micuentz1/TPO_TD2/README.md

# TPO_TD2
Proyecto Cafetera tipo italiana automática - Técnicas Digitales 2 - Curso R4051 - UTN FRBA - 2022
