micuentz1/TPO_TD2/CafeteraItaliana/Core/Src/main.c

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
/* Includes ------------------------------------------------------------------*/
#include "main.h"
#include "cmsis_os.h"
#include "fatfs.h"

/* USER CODE BEGIN Includes */
#include "liquidcrystal_i2c.h"
#include "OneWire.h"
#include "stdio.h"
#include "MdE.h"
#include "funciones.h"
#include "File_Handling_RTOS.h"
//#include "handlers.h"
/* USER CODE END Includes */

/* USER CODE BEGIN PM */
void my_ftoa(float n, char* res, int afterpoint);
int intToStr(int x, char str[], int d);
void reverse(char* str, int len);
/* USER CODE END PM */

I2C_HandleTypeDef hi2c1;

RTC_HandleTypeDef hrtc;

SPI_HandleTypeDef hspi1;

TIM_HandleTypeDef htim1;
TIM_HandleTypeDef htim3;

UART_HandleTypeDef huart1;

osThreadId defaultTaskHandle;
void SystemClock_Config(void);
static void MX_GPIO_Init(void);
static void MX_I2C1_Init(void);
static void MX_USART1_UART_Init(void);
static void MX_RTC_Init(void);
static void MX_SPI1_Init(void);
static void MX_TIM1_Init(void);
static void MX_TIM3_Init(void);
void StartDefaultTask(void const * argument);

/* USER CODE BEGIN 0 */
extern float Temp[MAXDEVICES_ON_THE_BUS];
TaskHandle_t Handler_Lectura;
TaskHandle_t Handler_Sensores;
TaskHandle_t Handler_Anafe;
TaskHandle_t Handler_Timer;
TaskHandle_t Handler_Timer2;

uint8_t toggle_reset = 1;

extern uint8_t estado_comp;
extern char componentes[4];
/* USER CODE END 0 */

/**
  * @brief  The application entry point.
  * @retval int
  */
int main(void)
{
  /* MCU Configuration--------------------------------------------------------*/

  /* Reset of all peripherals, Initializes the Flash interface and the Systick. */
  HAL_Init();

  /* Configure the system clock */
  SystemClock_Config();

  /* Initialize all configured peripherals */
  MX_GPIO_Init();
  MX_I2C1_Init();
  MX_USART1_UART_Init();
  MX_RTC_Init();
  MX_SPI1_Init();
  MX_FATFS_Init();
  MX_TIM1_Init();
  MX_TIM3_Init();
  /* USER CODE BEGIN 2 */

  InitAll();


  /* USER CODE END 2 */

  /* USER CODE BEGIN RTOS_MUTEX */
  /* add mutexes, ... */
  /* USER CODE END RTOS_MUTEX */

  /* USER CODE BEGIN RTOS_SEMAPHORES */
  /* add semaphores, ... */
  /* USER CODE END RTOS_SEMAPHORES */

  /* USER CODE BEGIN RTOS_TIMERS */
  /* start timers, add new ones, ... */
  /* USER CODE END RTOS_TIMERS */

  /* USER CODE BEGIN RTOS_QUEUES */
  /* add queues, ... */
  /* USER CODE END RTOS_QUEUES */

  /* Create the thread(s) */
  /* definition and creation of defaultTask */
  osThreadDef(defaultTask, StartDefaultTask, osPriorityNormal, 0, 128);
  defaultTaskHandle = osThreadCreate(osThread(defaultTask), NULL);

  /* USER CODE BEGIN RTOS_THREADS */
  /* add threads, ... */


  xTaskCreate(MdE_Principal, "MdE", configMINIMAL_STACK_SIZE*2, NULL, 1, NULL);
  xTaskCreate(DriverTeclado, "Driver Teclado", configMINIMAL_STACK_SIZE, NULL, 1, NULL);
  xTaskCreate(Tarea_BOTON_ON, "Boton ON", configMINIMAL_STACK_SIZE, NULL, 1, NULL);
  xTaskCreate(Tarea_Lectura, "Lectura Temperatura", configMINIMAL_STACK_SIZE, NULL, 1, Handler_Lectura);
  xTaskCreate(Tarea_Timer, "Tarea Timer",configMINIMAL_STACK_SIZE,NULL, 1, Handler_Timer);
  xTaskCreate(Tarea_Timer2, "Tarea Timer 2",configMINIMAL_STACK_SIZE,NULL, 1, Handler_Timer2);
  xTaskCreate(Error_Sensores, "Error Sensores", configMINIMAL_STACK_SIZE, NULL, 1, Handler_Sensores);
  xTaskCreate(Error_Anafe, "Error Anafe", configMINIMAL_STACK_SIZE, NULL, 1, Handler_Anafe);

  HAL_TIM_Base_Start_IT(&htim1);
  /* USER CODE END RTOS_THREADS */

  /* Start scheduler */
  osKernelStart();

  /* We should never get here as control is now taken by the scheduler */
  /* Infinite loop */
  /* USER CODE BEGIN WHILE */
  while (1)
  {
    /* USER CODE END WHILE */

    /* USER CODE BEGIN 3 */

  }
  /* USER CODE END 3 */
}

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
/* USER CODE BEGIN Header_StartDefaultTask */
/**
  * @brief  Function implementing the defaultTask thread.
  * @param  argument: Not used
  * @retval None
  */
/* USER CODE END Header_StartDefaultTask */
void StartDefaultTask(void const * argument)
{
  /* USER CODE BEGIN 5 */
  /* Infinite loop */
  for(;;)
  {
    osDelay(1);
  }
  /* USER CODE END 5 */
}

/**
  * @brief  Period elapsed callback in non blocking mode
  * @note   This function is called  when TIM4 interrupt took place, inside
  * HAL_TIM_IRQHandler(). It makes a direct call to HAL_IncTick() to increment
  * a global variable "uwTick" used as application time base.
  * @param  htim : TIM handle
  * @retval None
  */
void HAL_TIM_PeriodElapsedCallback(TIM_HandleTypeDef *htim)
{
  if (htim->Instance == TIM4) {
    HAL_IncTick();
  }
}

/**
  * @brief  This function is executed in case of error occurrence.
  * @retval None
  */
void Error_Handler(void)
{
  /* USER CODE BEGIN Error_Handler_Debug */
  /* User can add his own implementation to report the HAL error return state */
  __disable_irq();
  while (1)
  {
  }
  /* USER CODE END Error_Handler_Debug */
}

#ifdef  USE_FULL_ASSERT
/**
  * @brief  Reports the name of the source file and the source line number
  *         where the assert_param error has occurred.
  * @param  file: pointer to the source file name
  * @param  line: assert_param error line source number
  * @retval None
  */
void assert_failed(uint8_t *file, uint32_t line)
{
  /* USER CODE BEGIN 6 */
  /* User can add his own implementation to report the file name and line number,
     ex: printf("Wrong parameters value: file %s on line %d\r\n", file, line) */
  /* USER CODE END 6 */
}
#endif /* USE_FULL_ASSERT */
