micuentz1/TPO_TD2/CafeteraItaliana/CafeteraItaliana.ioc

Mcu.UserName=STM32F103C8Tx
PA10.GPIO_Label=BOTON_ON
PA10.Signal=GPIO_Input
PA13.Signal=SYS_JTMS-SWDIO
PA14.Signal=SYS_JTCK-SWCLK
PA15.GPIO_Label=BOTON3
PA15.Signal=GPIO_Input
PA4.Signal=GPIO_Output
PA5.Signal=SPI1_SCK
PA6.Signal=SPI1_MISO
PA7.Signal=SPI1_MOSI
PA9.Signal=USART1_TX
PB10.GPIO_Label=BUZZER
PB10.Signal=GPIO_Output
PB12.GPIO_Label=LED_VERDE
PB12.Signal=GPIO_Output
PB13.GPIO_Label=LED_AMARILLO
PB13.Signal=GPIO_Output
PB14.GPIO_Label=LED_ROJO
PB14.Signal=GPIO_Output
PB15.GPIO_Label=RELAY
PB15.Signal=GPIO_Output
PB3.GPIO_Label=BOTON2
PB3.Signal=GPIO_Input
PB4.GPIO_Label=BOTON1
PB4.Signal=GPIO_Input
PB6.Signal=I2C1_SCL
PB7.Signal=I2C1_SDA
PC14-OSC32_IN.Signal=RCC_OSC32_IN
PC15-OSC32_OUT.Signal=RCC_OSC32_OUT
PD0-OSC_IN.Signal=RCC_OSC_IN
PD1-OSC_OUT.Signal=RCC_OSC_OUT
