micuentz1/TPO_TD2/CafeteraItaliana/Core/Inc/main.h

#define BUZZER_Pin GPIO_PIN_10
#define BUZZER_GPIO_Port GPIOB
#define LED_VERDE_Pin GPIO_PIN_12
#define LED_VERDE_GPIO_Port GPIOB
#define LED_AMARILLO_Pin GPIO_PIN_13
#define LED_AMARILLO_GPIO_Port GPIOB
#define LED_ROJO_Pin GPIO_PIN_14
#define LED_ROJO_GPIO_Port GPIOB
#define RELAY_Pin GPIO_PIN_15
#define RELAY_GPIO_Port GPIOB
#define BOTON_ON_Pin GPIO_PIN_10
#define BOTON_ON_GPIO_Port GPIOA
#define BOTON3_Pin GPIO_PIN_15
#define BOTON3_GPIO_Port GPIOA
#define BOTON2_Pin GPIO_PIN_3
#define BOTON2_GPIO_Port GPIOB
#define BOTON1_Pin GPIO_PIN_4
#define BOTON1_GPIO_Port GPIOB
