micuentz1/TPO_TD2/(commit log)

2022-10-15 Subido proyecto de LCD con sensor
2022-10-31 Carpeta con la MDE y su codigo
2022-11-04 Agrego Proyecto de chequeo de errores
    [MdE.c, MdE.h, funciones.c, funciones.h, main.c, main.h]
2022-11-09 Prueba Errores v1.1 - Agrego Tarea para leer temperatura
    [LEDS3 Debug.cfg]
2022-11-09 Proyecto V1.5 - Agrego primer intento de menú en display
    [LEDS3 Debug.cfg]
2022-11-12 Prueba de LCD
2022-12-02 Intento FatFS+FreeRTOS
    [SD1.cfg, SDFRTOS Debug.cfg]
2022-12-17 Intento 2 FatFS+FreeRTOS
    [ADC_DHT_SD_RTOS Debug.cfg]
2022-12-19 Agrego suspensión de tareas
    [Debounceado Debug.cfg, LCDconSENSOR.cfg]
2022-12-19 Dalr que estamos
2022-12-21 Ordenado del repositorio
    [ADC_DHT_SD_RTOS Debug.cfg, Debounceado Debug.cfg, LCDconSENSOR.cfg, LEDS3 Debug.cfg, SD1.cfg, SDFRTOS Debug.cfg]
2022-12-21 Archivos de entrega
