micuentz1/TPO_TD2/(notices)

Notices in the files:
CafeteraItaliana/Core/Inc/main.h:
Copyright (c) 2022 STMicroelectronics.
All rights reserved.
This software is licensed under terms that can be found in the LICENSE file
